dheeraj-b-06/flyback-smps-kicad/SMPS_12V_5A.kicad_pcb

## KiCad design SMPS_12V_5A.kicad_pcb (2026-11-07)

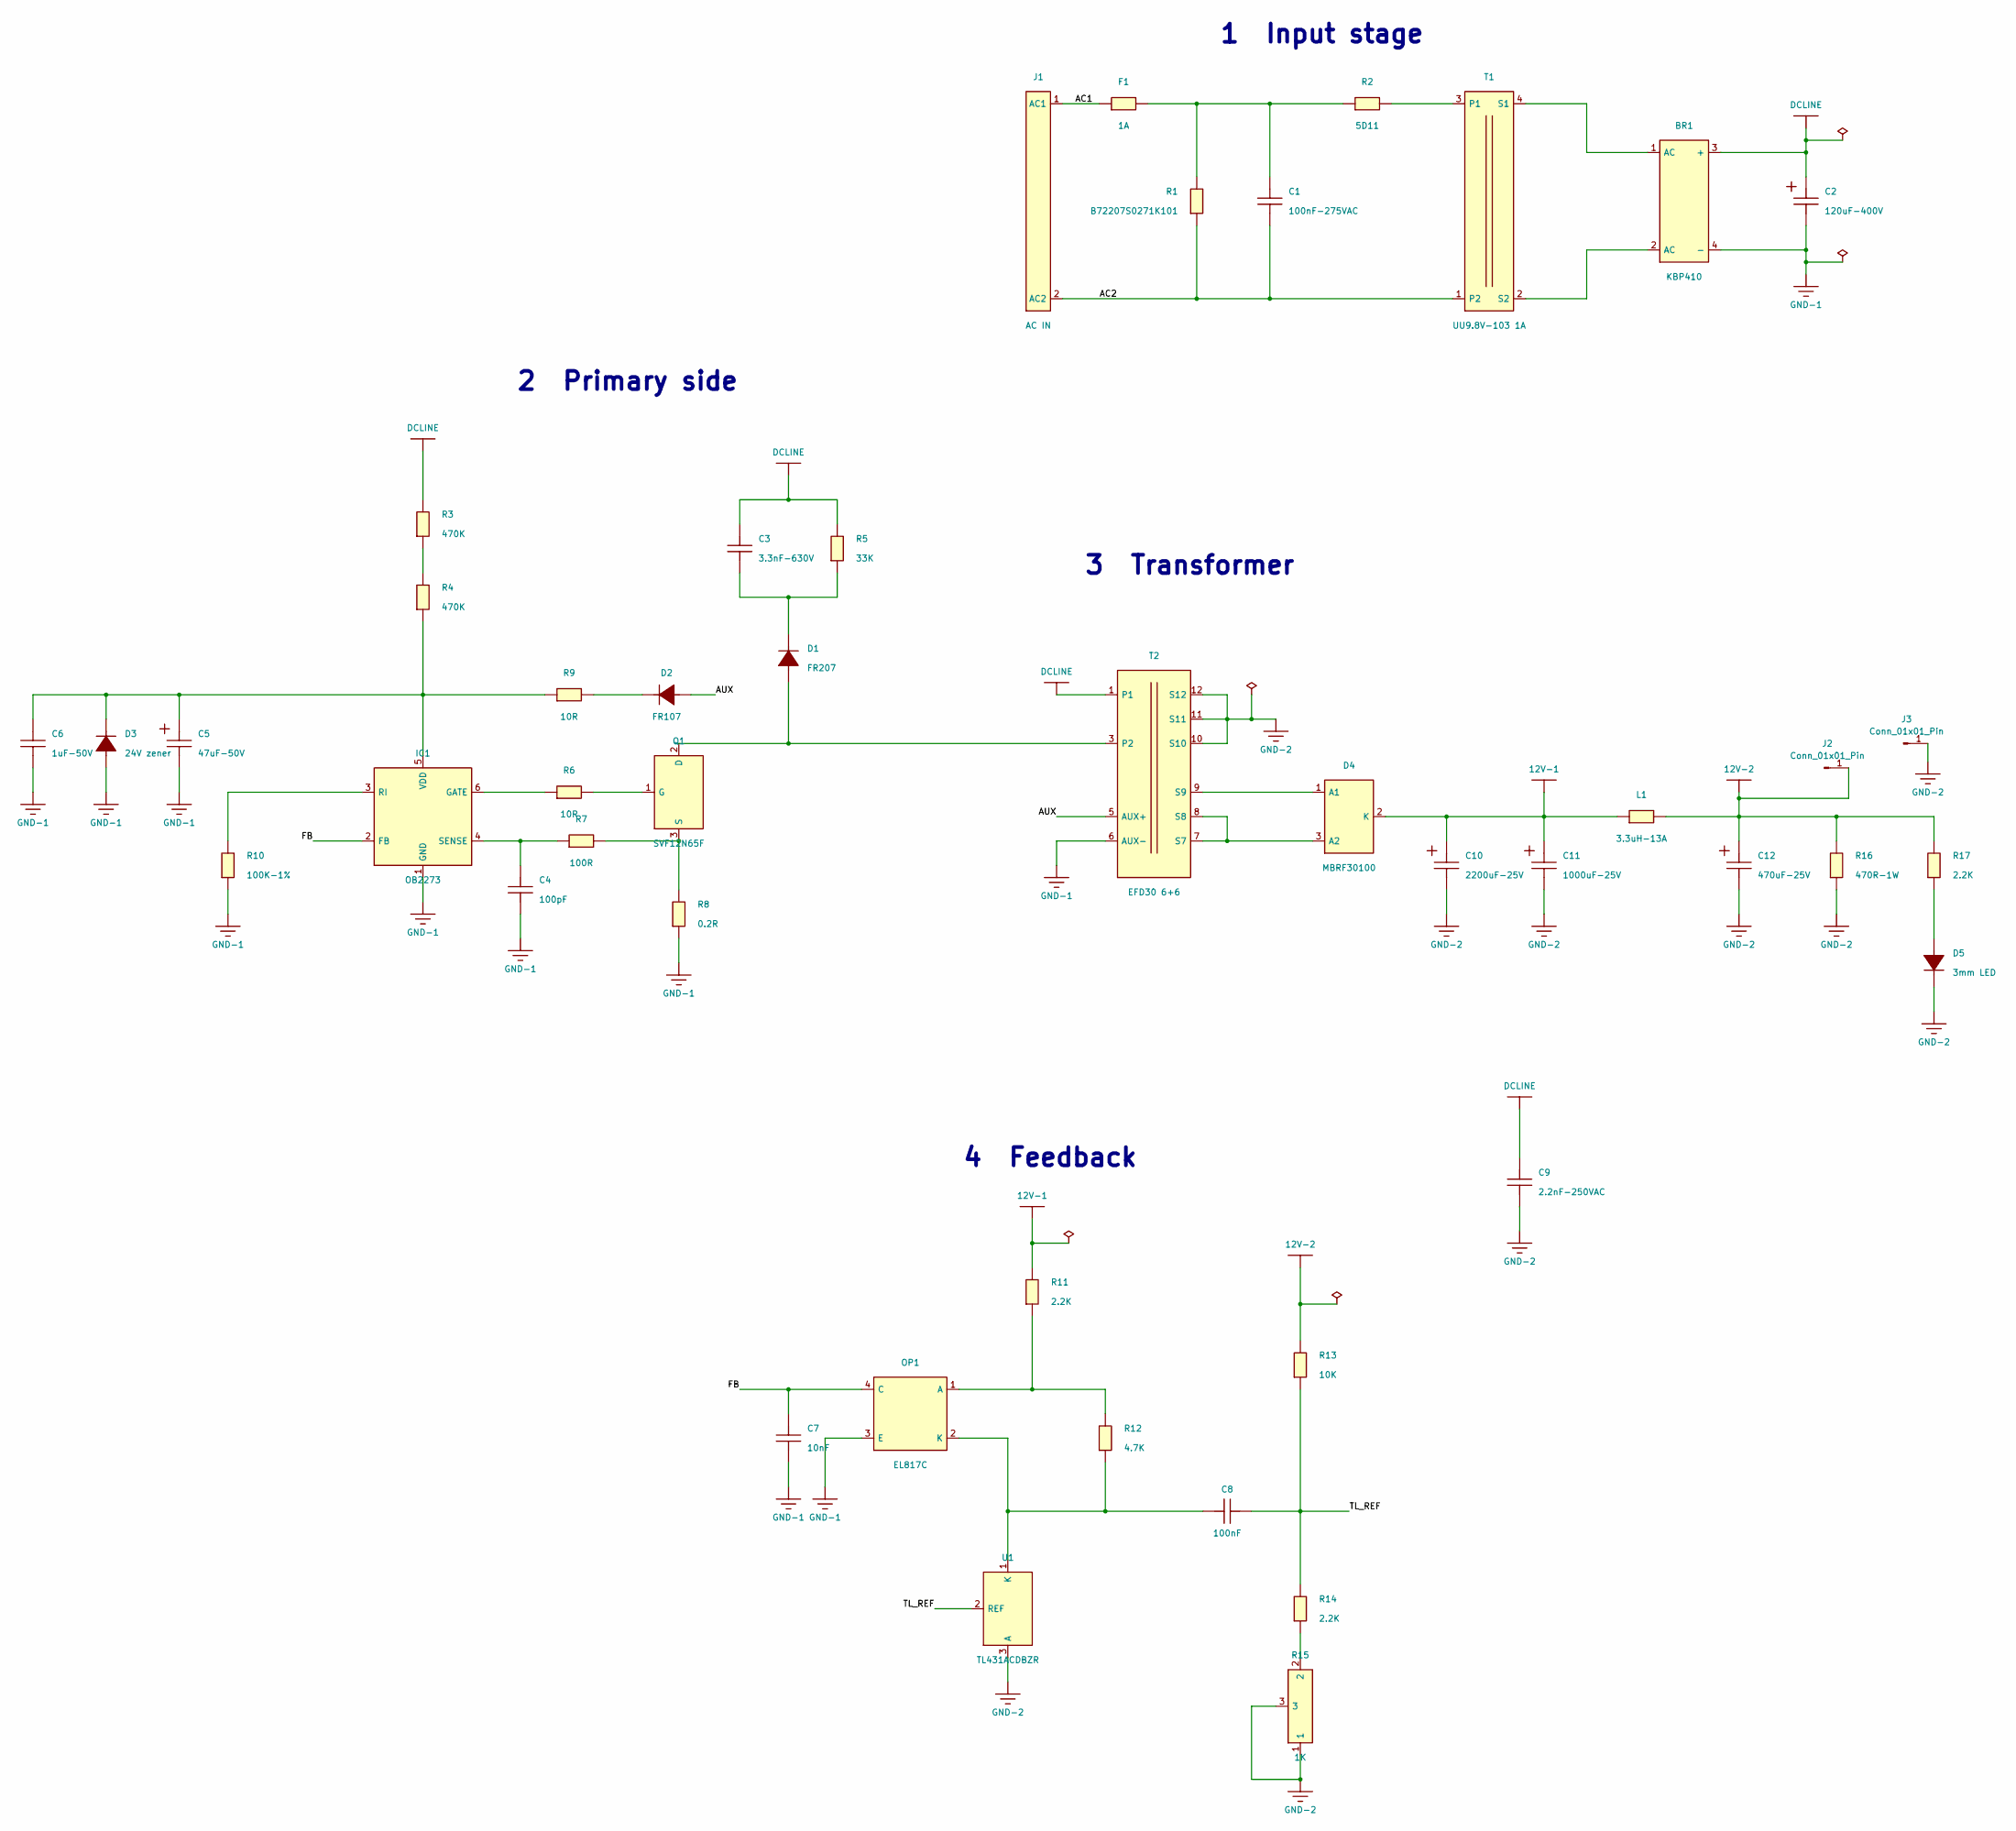
[picture p1: schematic SMPS_12V_5A.kicad_sch, SMPS]

Parts:
BR1: KBP410; C382768_KBP_4P-L14_5-W3_5-P3_81-L
C1: 100nF-275VAC; C_Rect_L18.0mm_W6.0mm_P15.00mm_FKS3_FKP3
C2: 120uF-400V; C_Box_P7.62mm_18x32.5mm
C3: 3.3nF-630V; C_1206_3216Metric
C4: 100pF; C_0805_2012Metric
C5: 47uF-50V; C_Radial_D6.3mm_H7.0mm_P2.50mm
C6: 1uF-50V; C_0805_2012Metric
C7: 10nF; C_0805_2012Metric
C8: 100nF; C_0805_2012Metric
C9: 2.2nF-250VAC; C_Disc_D7.0mm_W2.5mm_P5.00mm
C10: 2200uF-25V; C_Radial_D12.5mm_H20.0mm_P5.00mm
C11: 1000uF-25V; C_Radial_D10.0mm_H12.5mm_P5.00mm
C12: 470uF-25V; C_Radial_D8.0mm_H7.0mm_P3.50mm
D1: FR207; D_DO-15_P12.70mm_Horizontal
D2: FR107; D_DO-41_SOD81_P10.16mm_Horizontal
D3: 24V zener; D_MiniMELF
D4: MBRF30100; TO-220F-3_Vertical
D5: 3mm LED; LED_D3.0mm
F1: 1A; C3098_FUSE-TH_L8_5-W4_0-P5_08-D0_6
IC1: OB2273; SOT-23-6
J1: AC IN; TerminalBlock_bornier-2_P5.08mm
J2, J3: Conn_01x01_Pin; SolderWire-1.5sqmm_1x01_D1.7mm_OD3mm
L1: 3.3uH-13A; L_Wuerth_HCI-1350
OP1: EL817C; DIP-4_W7.62mm
Q1: SVF12N65F; TO-220F-3_Vertical
R1: B72207S0271K101; C125493_RES-TH_L9_0-W4_6-P5_00-D0_9-S3_4
R2: 5D11; RV_Disc_D9mm_W3.8mm_P5mm
R3, R4: 470K; R_1206_3216Metric
R5: 33K; R_2512_6332Metric
R6: 10R; R_0805_2012Metric
R7: 100R; R_0805_2012Metric
R8: 0.2R; R_2512_6332Metric
R9: 10R; R_1206_3216Metric
R10: 100K-1%; R_0805_2012Metric
R11, R14, R17: 2.2K; R_0805_2012Metric
R12: 4.7K; R_0805_2012Metric
R13: 10K; R_0805_2012Metric
R15: 1K; Potentiometer_Bourns_3296W_Vertical
R16: 470R-1W; R_2512_6332Metric
T1: UU9.8V-103 1A; C5276603_FILTER-TH_CMI-UU9_8-25MH
T2: EFD30 6+6; Transformer_EE_12pin_P5.08mm_Row27.56mm
U1: TL431ACDBZR; SOT-23

Connections:
12V-1: C10.1, C11.1, D4.2 (K), L1.1, R11.1
12V-2: C12.1, J2.1, L1.2, R13.1, R16.1, R17.1
/AC1: F1.1, J1.1 (AC1)
/AC2: C1.2, J1.2 (AC2), R1.2, T1.1 (P2)
/AUX: D2.2, T2.5 (AUX+)
/FB: C7.1, IC1.2 (FB), OP1.4 (C)
/TL_REF: C8.2, R13.2, R14.1, U1.2 (REF)
DCLINE: BR1.3 (+), C2.1, C3.1, C9.1, R3.1, R5.1, T2.1
GND-1: BR1.4 (-), C2.2, C4.2, C5.2, C6.2, C7.2, D3.2, IC1.1 (GND), OP1.3 (E), R8.2, R10.2, T2.6 (AUX-)
GND-2: C9.2, C10.2, C11.2, C12.2, D5.1, J3.1, R15.1, R15.3, R16.2, T2.10 (S10), T2.11 (S11), T2.12 (S12), U1.3 (A)
unnamed: C1.1, F1.2, R1.1, R2.1
unnamed: C3.2, D1.1, R5.2
unnamed: D2.1, R9.2
unnamed: D4.1 (A1), T2.9 (S9)
unnamed: D4.3 (A2), T2.7 (S7), T2.8 (S8)
unnamed: D5.2, R17.2
unnamed: IC1.6 (GATE), R6.1
unnamed: IC1.3 (RI), R10.1
unnamed: C4.1, IC1.4 (SENSE), R7.1
unnamed: C5.1, C6.1, D3.1, IC1.5 (VDD), R4.2, R9.1
unnamed: OP1.1 (A), R11.2, R12.1
unnamed: C8.1, OP1.2 (K), R12.2, U1.1 (K)
unnamed: D1.2, Q1.2 (D), T2.3 (P2)
unnamed: Q1.1 (G), R6.2
unnamed: Q1.3 (S), R7.2, R8.1
unnamed: R3.2, R4.1
unnamed: R14.2, R15.2
unnamed: R2.2, T1.3 (P1)
unnamed: BR1.1 (AC), T1.4 (S1)
unnamed: BR1.2 (AC), T1.2 (S2)

Notes on the sheet:
2 Primary side
1 Input stage
3 Transformer
4 Feedback

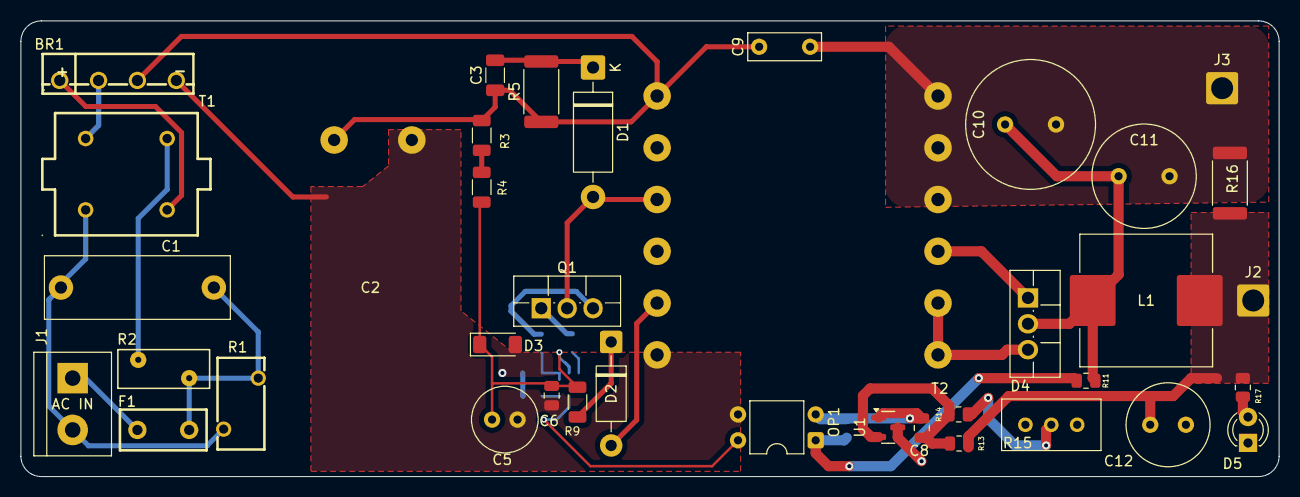
[picture p2: board SMPS_12V_5A.kicad_pcb from above]

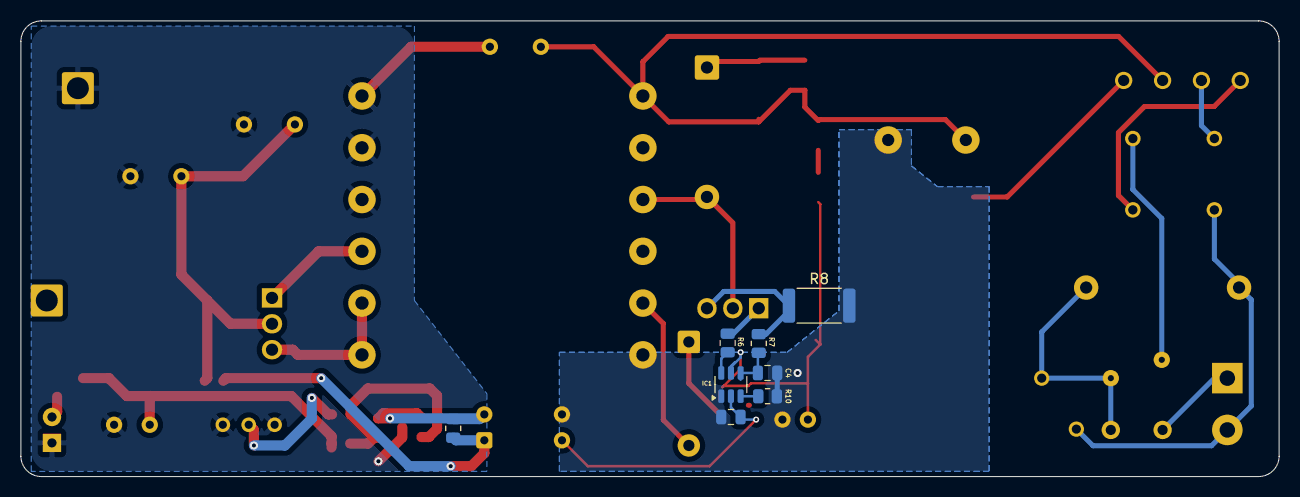
[picture p3: board SMPS_12V_5A.kicad_pcb from below]

Board: 2 copper layers, 123.4 x 44.7 mm, 46 parts (8 on the bottom side), 30 nets.
